Pushkash083/16BitFlash_Programmer/README.md

# 16BitFlash Programmer (SEGA Mega Drive / Genesis)

🌐 **Язык / Limba / Language:** [Русский](README.md) | [Română](README_RO.md) | [English](README_EN.md)





> 💡 **История проекта:** Проект изначально задумывался как простой эксперимент для изучения работы COM-порта, протокола UART и передачи данных между ПК и внешними устройствами, но вырос в полноценный профессиональный программатор.

Программатор на базе микроконтроллера **Raspberry Pi Pico (RP2040) или Arduino Nano**  и управляющего ПО на **Qt 6 C++** для **Чтения, Записи, Стирания, Проверка и Auto-ID:** 16-битных Flash-микросхем (серии **MX29LV, AM29LV, S29GL** и др.) и картриджей **SEGA Mega Drive / Genesis**.

---

## 🚀 Что нового в версии v4.3.0

Версия **v4.3.0** вобрала в себя весь проверенный функционал прошлых версий и получила масштабные обновления для работы с железом и гибкости настройки:

### 1. Кнопка «Chip ID» (Автоопределение чипа)
* Реализована функция автоматического определения микросхемы по её уникальным идентификаторам (MID и CID), считываемым через микроконтроллер RP2040 или Arduino.
* На главный интерфейс добавлены информационные метки (`Chip Information`), отображающие название определенного чипа, его ID и реальный объем памяти.
* При открытии файла большего размера выбор в программе допускается, но буфер и настройки автоматически урезаются до физического размера микросхемы.

### 2. Внешняя база данных микросхем (`chips.txt`)
* Добавлена поддержка внешнего конфигурационного файла **`chips.txt`**, располагающегося рядом с исполняемым файлом программы. Из него приложение автоматически считывает названия, производителей (`MID`), ID устройства (`CID`) и размеры микросхем.
* **Автосоздание шаблона:** Если файла нет, программа автоматически создаёт его со стартовым набором чипов и комментариями. Теперь можно самостоятельно добавлять новые чипы в текстовом файле без необходимости перекомпилировать исходный код программы.

### 3. Аппаратный мониторинг стирания по биту `DQ7`
* Убраны старые задержки: теперь процесс стирания поправлен по состоянию бита **`DQ7`** с визуальным миганием светодиода на плате RP2040 или Arduino.
* На стороне ПК-приложения внедрен надежный асинхронный перехват статуса готовности через сигналы с защитным таймером, благодаря чему интерфейс программы полностью отзывчив во время стирания.

---

## 📜 Архив истории версий (Changelog History)

<details>
<summary><b>🔽 Нажмите, чтобы развернуть историю предыдущих версий </b></summary>

### Версия v3.1.1
* **Qt 6 GUI:** Добавлена возможность выбора и работы с образами объемом до 32 МБ в интерфейсе программы.
* **Поддержка RP2040:** Добавлены новые скетчи для Raspberry Pi Pico (RP2040) с поддержкой Sega Bank Switching (SSF2 Mapper).
* **Чтение и запись (SSF2):** Реализована стабильная поддержка чтения и записи ROM-образов объемом до 32 МБ через маппер SSF2 на железе без необходимости пайки (требуется картридж со встроенным маппером).

### Версия v3.1.0
* **Обновление интерфейса ПО (Qt GUI):** Улучшен пользовательский интерфейс, оптимизировано управление размерами ROM через выпадающий список (`QComboBox`).
* **Оптимизация протокола обмена:** Десктопное приложение адаптировано и оптимизировано для работы с высокими скоростями **RP2040**.

### Версия v3.0.0
* **Переход на RP2040 (Raspberry Pi Pico):** 32-битный микроконтроллер ARM Cortex-M0+.
* **Обновление ПО для ПК (Qt GUI):** В десктопное приложение добавлена полная поддержка и оптимизация протокола обмена для микроконтроллера **RP2040**.
* **Прирост скорости:** Время записи **1 МБ** сократилось с **~30 минут** (на Arduino Nano) до **~5 минут** (на RP2040). Запись огромных дампов на **15 МБ** занимает всего **~1 час 10 минут** вместо **~8 часов 20 минут** (на Arduino Nano).
* **Обновленная печатная плата (PCB v3.0.0):** Двухслойная плата с двойным посадочным местом (Pico + Nano), светодиодной индикацией операций и поддержкой быстрых расширителей **MCP23S17 (SPI)** / **MCP23017 (I2C)**.

### Версия v2.0.4
* **Умный Auto ROM Select:** Автоматически определяет размер файла. Если объём совпадает со стандартным — выбирает соответствующий пресет; если нет — передаёт на микроконтроллер точный конечный адрес файла произвольного размера. Для работы с объемами свыше 4 MB (8 MB и 16 MB) требуется распайка линий $A21/A22$.
* **Скорость работы:** Чтение 1 MB занимает ~3.2 мин. Из-за аппаратных ограничений Arduino Nano (16 МГц), протокола UART и I2C/SPI запись происходит медленно — ~30 мин на 1 MB.
* **Аппаратная интеграция:** Шина данных 16-бит через MCP23017 (I2C) / MCP23S17 (SPI), шина адреса через каскад 74HC595.
* **Двунаправленный Byte Swapping:** Программатор сам автоматически переставляет байты и при чтении, и при записи. Файлы `.bin`, `.gen`, `.md` сразу готовы для работы без сторонних утилит.
* **Быстрое тестирование:** Режим `TEST 32KB` позволяет быстро проверить шину и чип без задержек.
* **Проверка дампа:** Опциональная проверка данных кнопкой `Verify` по желанию после записи.
* **Защита процессов:** Блокировка спящего режима ОС во время работы с Flash.

---

</details>

---

## 🖥 Интерфейс и возможности ПО (Qt GUI)

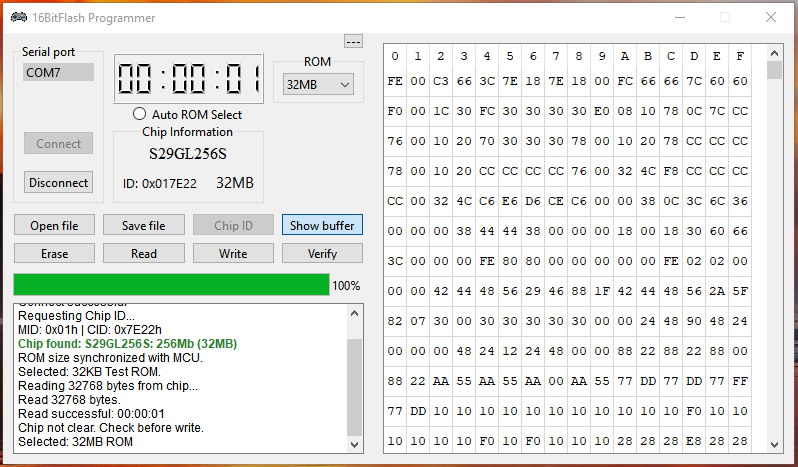
[picture p1: Interface.png]
Interface


* **Мониторинг:** LCD-таймер операций и окно консольного лога.
* **Карточка Chip Information:** Информационная панель на главном экране, отображающая название определенного чипа, его ID и реальный объем памяти.
* **Выбор объема / Auto ROM Select:** Пресеты от 512 KB до 32 MB, `TEST 32KB` (быстрая проверка) и смарт-режим **`Auto ROM Select`**.
* **Hex-просмотрщик:** Встроенная визуализация дампов памяти на 16 колонок (`Show buffer`).
* **Основные операции:** Чтение, Запись, Стирание, Проверка и Автоопределение микросхемы.

---

## 🌟 Ключевые особенности

* **Автовыбор чипа и Auto-ID:** Автоматическое определение модели и параметров микросхемы по ее уникальным идентификаторам.
* **Автоопределение объема памяти по ID:** Программа сама сопоставляет считанные MID/CID с базой `chips.txt` и выставляет корректный размер.
* **Маппер SSF2 (до 32 МБ):** Поддержка банковской коммутации для работы с крупными ROM-образами. Для этого используются специальные скетчи для RP2040 с суффиксом **`"_SSFmap"`** (предназначены **исключительно** для картриджей со встроенным маппером SSF2). При использовании стандартных скетчей без маппера для работы с объемами свыше 4 MB (8 MB и 16 MB) требуется обязательная распайка дополнительных адресных линий микросхемы **`A21/A22`**.
* **Двунаправленный Byte Swapping:** Программатор автоматически переставляет байты при чтении и записи.
* **Аппаратная интеграция:** Шина данных 16-бит через MCP23017 (I2C) / MCP23S17 (SPI), шина адреса через каскад 74HC595.
* **Скорость записи (1 МБ):** ~5 минут на Raspberry Pi Pico (против ~30 минут на Arduino Nano).
* **Защита процессов:** Блокировка спящего режима ОС во время работы с Flash и защита буфера от превышения объема микросхемы.

---

## 🔌 Схема подключения

### 1. Шина адреса (74HC595)
| Сигнал | RP2040 (Pico) | Arduino Nano |
| :--- | :--- | :--- |
| **SER (Data)** | GP2 | A0 |
| **L_CLK (Latch)** | GP3 | A1 |
| **S_CLK (Clock)** | GP6 | A2 |

### 2. Линии управления Flash-памятью и Индикация
| Сигнал | Слот (Pin) | RP2040 (Pico) | Arduino Nano | Описание |
| :--- | :--- | :--- | :--- | :--- |
| **LED (W/R)** | — | GP20 | D7 | Светодиодный индикатор процесса чтения/записи |
| **#WE** | B30 | GP7 | A3 | Write Enable (LOW) |
| **#CE** | B17 | GP8 | D8 | Chip Enable (LOW) |
| **#OE** | B16 | GP9 | D9 | Output Enable (LOW) |
| **#TIME** | B31 | GP21 | D5 | Time/Peripheral chip select |
| **#LWR** | B28 | GP22 | D6 | Lower Byte Write |
| **#RST** | B27 | RUN | RESET | Линия сброса (Reset) |

### 3. Шина данных (MCP23S17 / MCP23017)

#### MCP23017 (I2C Mode)
| Сигнал MCP23017 | RP2040 (Pico) | Arduino Nano | Описание |
| :--- | :--- | :--- | :--- |
| **SDA** | GP4 | A4 | I2C Data Line |
| **SCL** | GP5 | A5 | I2C Clock Line |

#### MCP23S17 (SPI Mode — Рекомендуется)
| Сигнал MCP23S17 | RP2040 (Pico) | Arduino Nano | Описание |
| :--- | :--- | :--- | :--- |
| **CS** | GP17 | D10 | Chip Select |
| **SCK** | GP18 | D13 | SPI Clock |
| **MOSI (SI)** | GP19 | D11 | Master Out Slave In |
| **MISO (SO)** | GP16 | D12 | Master In Slave Out |

---

## 💾 Поддерживаемые чипы

Программа поддерживает широкий набор 16-битных параллельных Flash-памятей, включая:
* **Macronix:** MX29LV400, MX29LV800, MX29LV160, MX29LV320, MX29LV640
* **AMD / Fujitsu / Spansion:** AM29LV800, MBM29LV400/800
* **STMicroelectronics / Eon / EliteMT:** M29W160, EN29LV160/800, ES29LV800, HY29F800 и др.
* **Spansion / Cypress:** Семейство S29GL (S29GL256S, S29GL128S, S29GL064x, S29GL032x и др.)

*(Полный перечень всегда доступен для редактирования в файле `chips.txt` рядом с программой).*

---

## 🛠 Аппаратное обеспечение (Hardware)

В репозитории представлены файлы для самостоятельной сборки устройства (схема и плата остались стабильными с версии v3.0.0):
* **[Схема программатора и Gerber:](Hardware/v3.0.0)** — Принципиальная электрическая схема программатора и готовые Gerber-файлы для заказа производства печатной платы (PCB).

---

## 📦 Релизы и софт

* **ПО для Windows:** В разделе **[Releases](../../releases/latest)** доступна для скачивания управляющая программа в архиве `16BitFlash_Programmer_v4.3.0.7z`, а также исходный код проекта.
* **Видеообзор и демонстрация:** Посмотреть процесс работы и примеры использования можно на [YouTube-канале (Видеодемонстрация)](https://youtu.be/o0FTJ8lp1q4).

---

## 👨‍💻 Авторство

* **Разработчик:** Pushkash
* **AI-ассистент:** Gemini
