Pushkash083/16BitFlash_Programmer/Arduino_sketch/v3.0.0/RP2040/sketch_RP2040_I2C/PIN.txt

//RP2040 + MCP23017 (I2C)
//Стандартная распиновка RP2040 (Default I2C0 / SPI0  ):
//==Управление:
//  WE = GP7
//  CE = GP8
//  OE = GP9
//==74HC595 (Адрес): 
//  DataPin =  GP2
//  LatchPin = GP3
//  ClockPin = GP6
//==MCP23S17 (SPI):
//  MISO = GP16
//  CS =   GP17
//  SCK =  GP18
//  MOSI = GP19
//==MCP23017 (I2C):
//->SDA = GP4
//->SCL = GP5

// ==Arduino=======RP2040===========
// =================================
// A0  -> SER       //GP2
// A1  -> L_CLK     //GP3
// A2  -> S_CLK     //GP6
//
// A4  -> A4(SDA)   //GP4
// A5  -> A5(SCL)   //GP5
//
// D13 -> SSCK      //GP18
// D12 -> SMISO     //GP16
// D11 -> SMOSI     //GP19
// D10 -> SCS       //GP17
//
// D9  -> OE        //GP9
// D8  -> CE        //GP8
// A3  -> WE        //GP7
//
// D7  -> W/R (LED) //GP20
// D5  -> TIME      //GP21
// D6  -> LWR       //GP22
//
// RESET  -> RST    == RUN
// =================================
/*
Adafruit MCP23X17 Library от Adafruit.
#include <Adafruit_MCP23X17.h>

Откройте Менеджер библиотек (Ctrl + Shift + I).
В строке поиска введите просто: MCP23017 или Adafruit MCP23017.
В списке найдите библиотеку с точным названием Adafruit MCP23017 Arduino Library (автор Adafruit).
Нажмите Install (Установить) и при запросе выберите Install all (чтобы подтянулся обязательный зависимый модуль Adafruit BusIO).

Adafruit BusIO.
Откройте Менеджер библиотек (Ctrl + Shift + I).
В поиске введите: Adafruit BusIO.
Найдите библиотеку Adafruit BusIO и нажмите Install.
*/
