Pushkash083/16BitFlash_Programmer/Hardware/v3.0.0/Arduino Nano.jpg

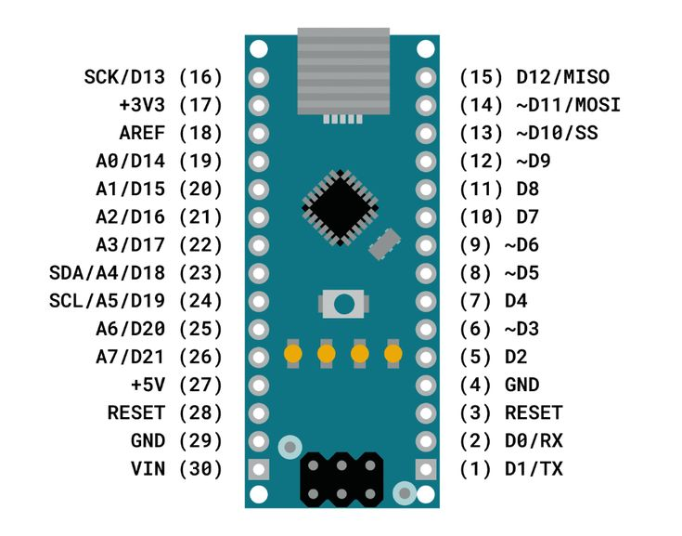
Hardware/v3.0.0/Arduino Nano.jpg
