Pushkash083/16BitFlash_Programmer/Hardware/v3.0.0/PCB_100x100mm_v3.0.0.png

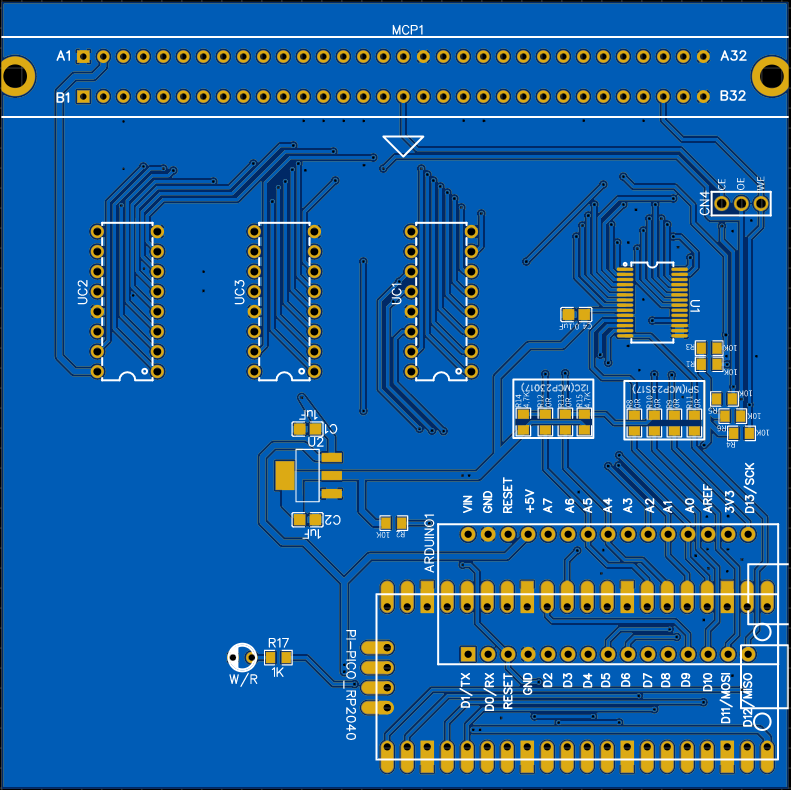
Hardware/v3.0.0/PCB_100x100mm_v3.0.0.png
