Pushkash083/16BitFlash_Programmer/Hardware/v3.0.0/YD-RP2040.png

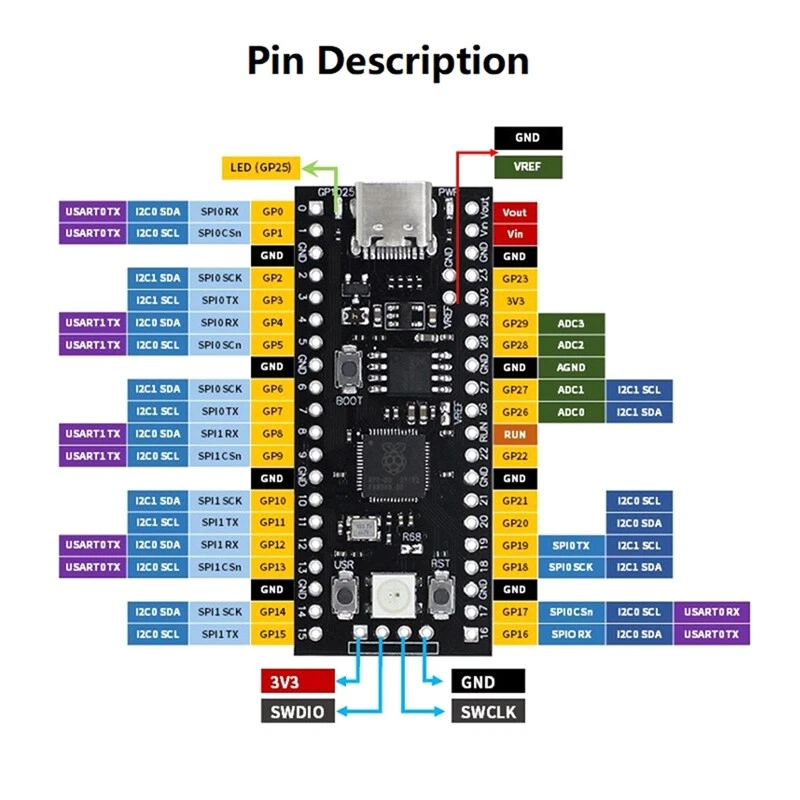
Hardware/v3.0.0/YD-RP2040.png
