Pushkash083/16BitFlash_Programmer/Hardware/v3.0.0/BOM_Gerber_PCB_v3.0.0.csv

ID | Name | Designator | Footprint | Quantity | Manufacturer Part | Manufacturer | Supplier | Supplier Part | Price
1 | 10K | R2,R1,R3,R4,R5,R6 | R0805 | 6 | RMCF0805FT10K0 | SEI(Stackpole Electronics Inc.) | LCSC | C237755 | 0.006
2 | PI-PICO_RP2040 | PICO1 | RASPBERRY-PI-PICO-RP2040 | 1 |  | Raspberry Pi Foundation |  | RP2040
3 | 3ARB9HCB | W/R | LED-3MM | 1 | 3ARB9HCB | KENTO | LCSC | C42016
4 | 1uF | C1,C2 | C0805 | 2 | 0805B221K501NT | FH(风华) | LCSC | C46326 | 0.018
5 | AT1117-3.3V | U2 | SOT-223-3_L6.5-W3.4-P2.30-LS7.0-BR-1 | 1 | AT1117SR-3.3V | Agertech(艾吉芯) | LCSC | C5221633 | 0.064
6 | 0.1uF | C4 | C0805 | 1 | 0805B221K501NT | FH(风华) | LCSC | C46326 | 0.018
7 | 0R | R8,R9,R10,R11,R12,R13 | R0805 | 6 | RMCF0805FT10K0 | SEI(Stackpole Electronics Inc.) | LCSC | C237755 | 0.006
8 | 4.7K | R14,R15 | R0805 | 2 | RMCF0805FT10K0 | SEI(Stackpole Electronics Inc.) | LCSC | C237755 | 0.006
9 | 1K | R17 | R0805 | 1 | RMCF0805FT10K0 | SEI(Stackpole Electronics Inc.) | LCSC | C237755 | 0.006
10 | ARDUINO_NANO | ARDUINO1 | ARDUINO_NANO | 1 | ?
11 | MD_CARD_64PIN | MCP1 | SEGA_CARD_SLOT | 1
12 | MCP23S17-E/SS | U1 | SSOP-28_L10.2-W5.3-P0.65-LS7.8-BL | 1 | MCP23S17-E/SS | MICROCHIP(美国微芯) | LCSC | C148009 | 1.641
13 | 74HC595N | UC1,UC2,UC3 | DIP-16_L20.0-W6.4-P2.54-LS7.6-BL | 3 | 74HC595N | HGSEMI(华冠) | LCSC | C507175 | 0.15
14 | XY2500V-T-2.5-3P | CN4 | T2.5-3P | 1 | XY2500V-T-2.5-3P | XINLAIYA(新莱亚) | LCSC | C784953 | 0.166
