Pushkash083/16BitFlash_Programmer/Hardware/v3.0.0/Schematic_ProgramatorLV_v3.0.0.pdf

## SPI(MCP23S17)

## I2C(MCP23017) SSCK²

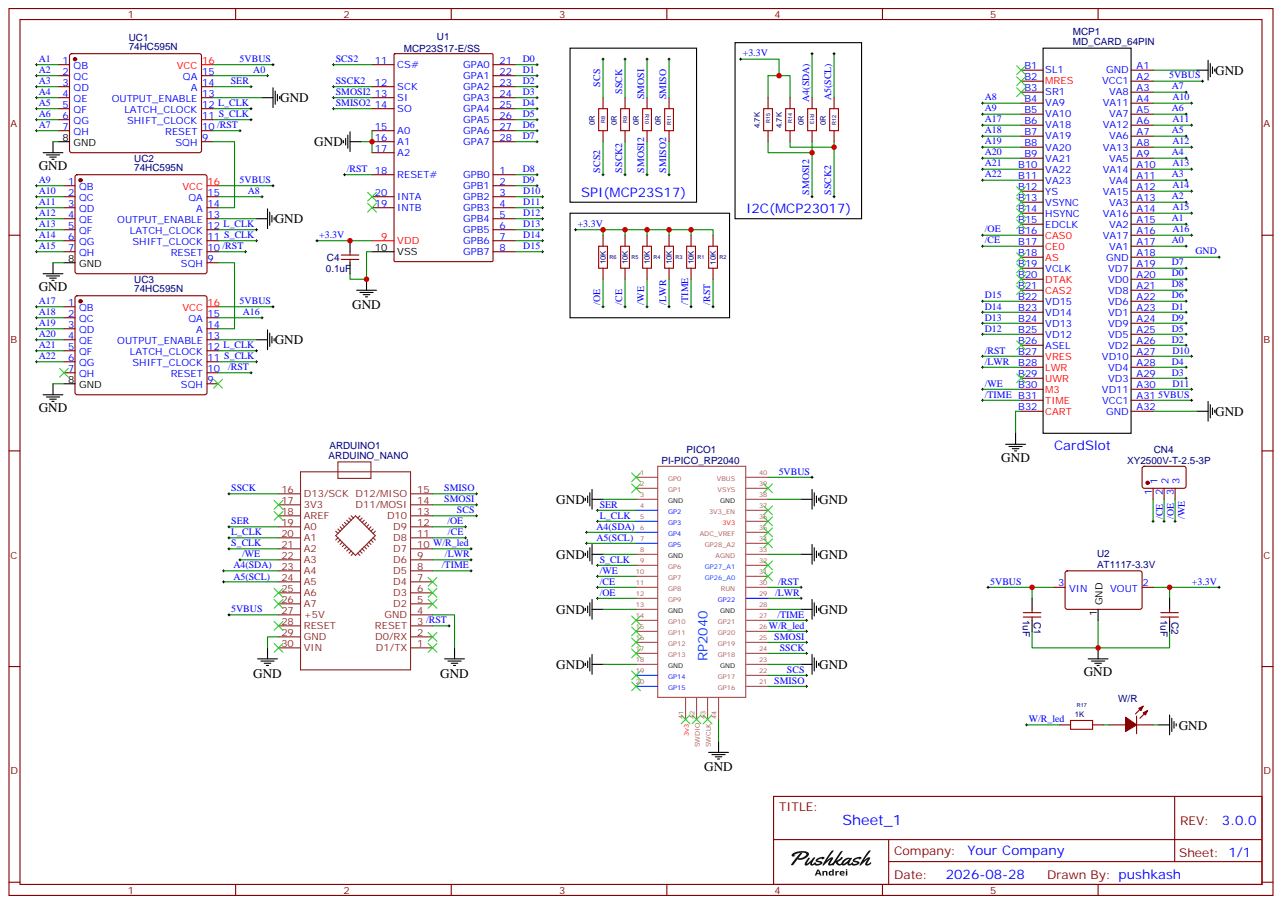
[picture p5: page 1]
