Pushkash083/16BitFlash_Programmer/Hardware/v2.0.4/Schematic_ProgramatorLV_v2.0.4.pdf

## SPI(MCP23S17) I2C(MCP23017)

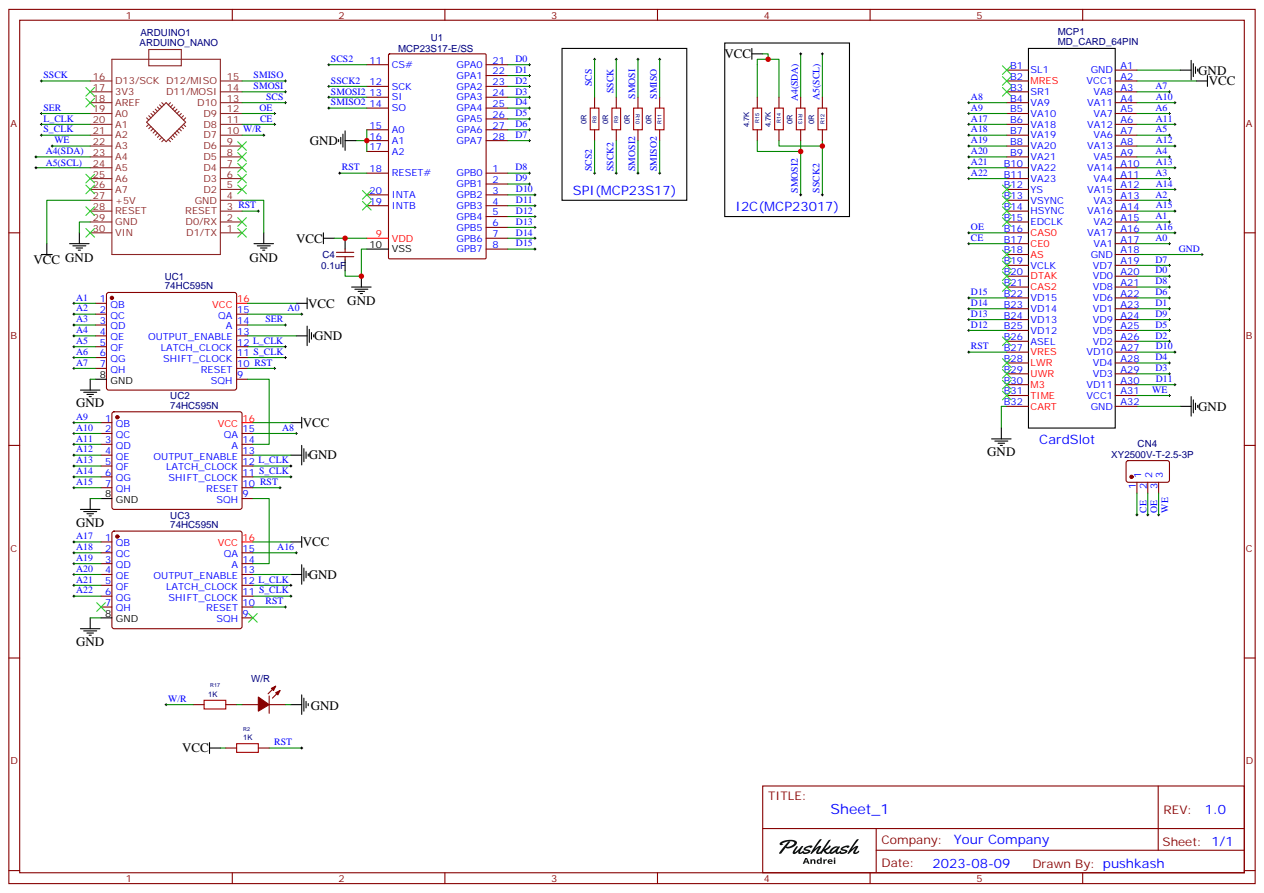
[picture p6: page 1]
