Pushkash083/16BitFlash_Programmer/(commit log)

2026-08-30 Add UF2 binaries for I2C and SPI firmware
    Add UF2 binaries for I2C and SPI firmware:
    /RP2040/sketch_RP2040_I2C/build/sketch_RP2040_I2C.uf2
    /RP2040/sketch_RP2040_SPI/build/sketch_RP2040_SPI.uf2
2026-10-22 16BitFlash Programmer v4.3.0
    ### 1. Кнопка «Chip ID» (Автоопределение чипа)
    * Реализована функция автоматического определения микросхемы по её уникальным идентификаторам (MID и CID).
    * На главный интерфейс добавлены информационные метки (`Chip Information`), отображающие название определенного чипа, его ID и реальный объем памяти.
    ### 2. Внешняя база данных микросхем (`chips.txt`)
    * Добавлена поддержка внешнего конфи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
