Pushkash083/16BitFlash_Programmer/(notices)

Notices in the files:
README_RO.md:
License: MIT
